mirkio90/spinlite/README.md

# SpinLite

Conta giri da pochi euro per launcher **Beyblade X**: ESP32-C3 SuperMini + sensore ottico QRE1113 + tasto di presenza della trottola + piccola LiPo, agganciato alla porta del Battle Pass del launcher.
I risultati arrivano al telefono via Bluetooth con lo stesso profilo del Bey Battle Pass, quindi funzionano le app esistenti (BeyGear, Spin Meter, Beyblader Helper, 321GoShoot). Display OLED 128x32 opzionale.

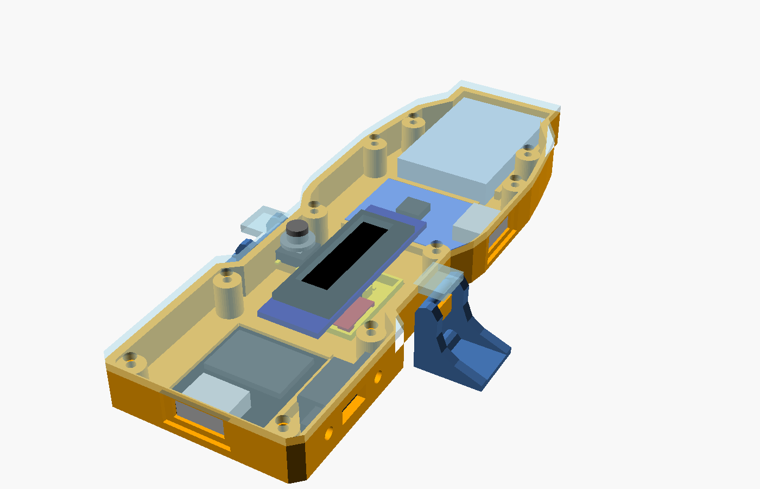
[picture p1: hardware/img/piatta_assieme.png]
Scatola piatta di SpinLite con il coperchio trasparente


Schema di cablaggio

**Costo indicativo: circa 17-21 €** con OLED, 15-19 € senza, prezzi di ottobre 2026: vedi la [distinta base](hardware/BOM.md).

## Link

- [Guida completa](docs/guida.md): distinta base, cablaggio, montaggio, taratura, limiti
- [Dashboard web](https://mirkio90.github.io/spinlite/)
- [Web flasher](https://mirkio90.github.io/spinlite/flasher/)
- [Distinta base (BOM)](hardware/BOM.md)
- [Scatola piatta: stampa e montaggio](docs/scatola-piatta.md)
- [Parti stampate e vecchi montaggi](hardware/README.md)

## Limiti da sapere subito

SpinLite misura l'**albero del launcher**, non la trottola. Con i launcher a corda anche il Battle Pass originale sovrastima gli RPM. Dettagli nella guida.

## Stato

| Parte | Stato |
| --- | --- |
| Rilevatore RPM (`rpm_detector.*`) | fatto: 21 casi simulati, errore tipico sotto lo 0,1% |
| Pacchetti Battle Pass (`bbp_protocol.*`) | fatto, verificato con un parser indipendente |
| Schermate OLED (`oled_ui.*`) | disegno testato; driver I2C da provare |
| Firmware ESP32-C3 (`spinlite.ino`: ADC, BLE, console) | scritto completo, **NON ancora provato su hardware** |
| Guida e BOM | scritte |
| Montaggio | [scatola piatta](docs/scatola-piatta.md) agganciata al launcher, con OLED, tasto di presenza e tasto esterno, verificata solo a CAD e non ancora stampata. Le scatole precedenti restano come archivio |
| Dashboard web e flasher | vedi i link sopra |

Finché non è provato sul campo, aspettati bug e soglie da tarare.

## Sviluppo

```
make -C test                  # test su PC (rilevatore, protocollo, OLED, impostazioni, presenza)
pio run -e spinlite_qre       # compila il firmware (QRE1113)
pio run -e spinlite_qre_oled  # con display OLED
pio run -e spinlite_qre -t upload  # carica sulla scheda
```

Il piano di lavoro e le note tecniche sono in `CLAUDE.md`.

## Licenza

MIT. Progetto non affiliato a Takara Tomy né a Hasbro. Crediti e licenze di terzi (LaunchLab, BRD, MarkChan0225, Migbello) nella guida.
