mirkio90/spinlite/hardware/img/interno_lato.png

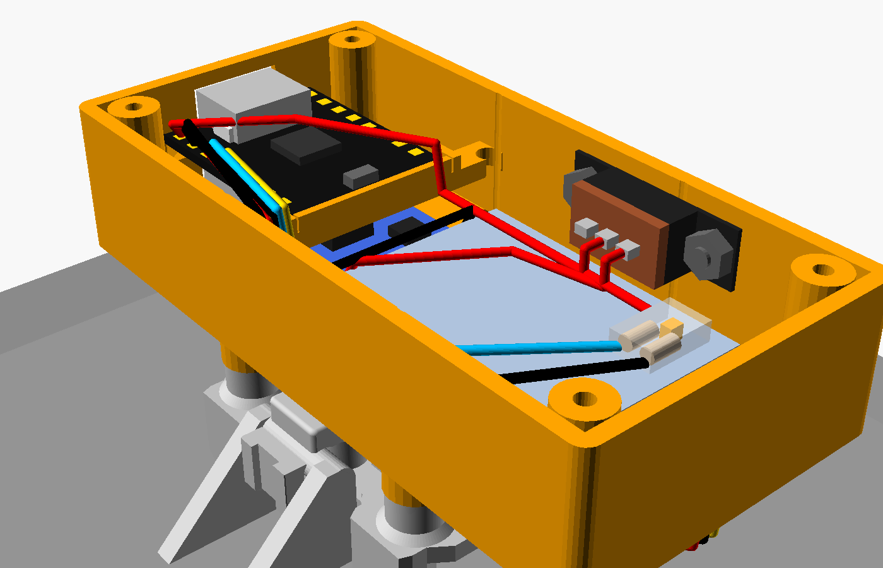
hardware/img/interno_lato.png
