mirkio90/spinlite/hardware/img/interno_oled.png

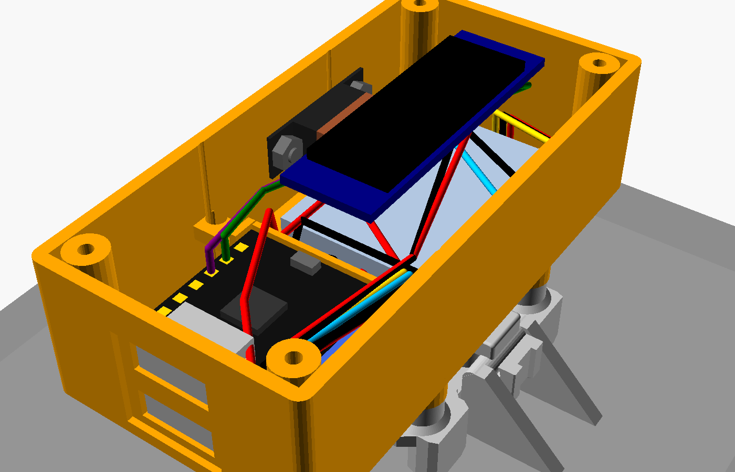
hardware/img/interno_oled.png
