mirkio90/spinlite/hardware/img/render_piatta.png

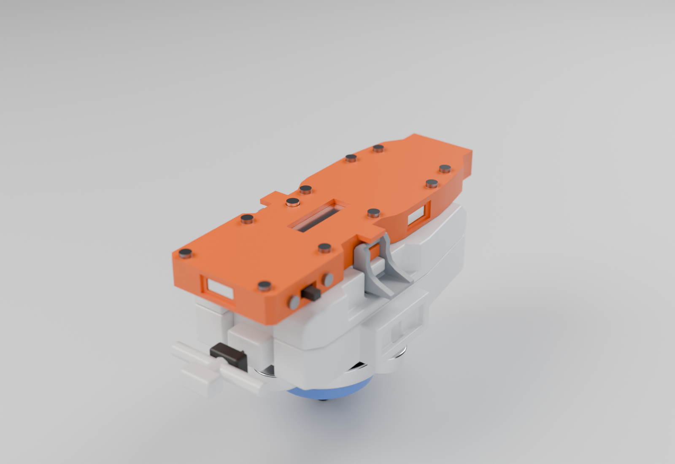
hardware/img/render_piatta.png
