mirkio90/spinlite/hardware/img/render_piatta_clip.png

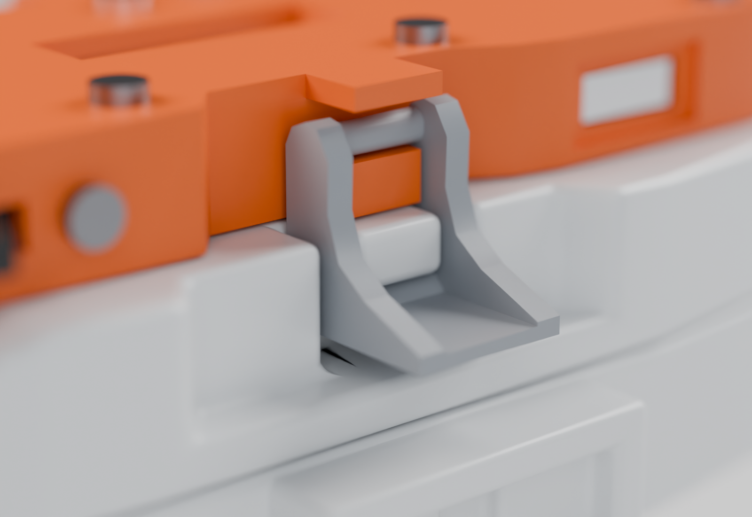
hardware/img/render_piatta_clip.png
