mirkio90/spinlite/hardware/img/render_piatta_fronte.png

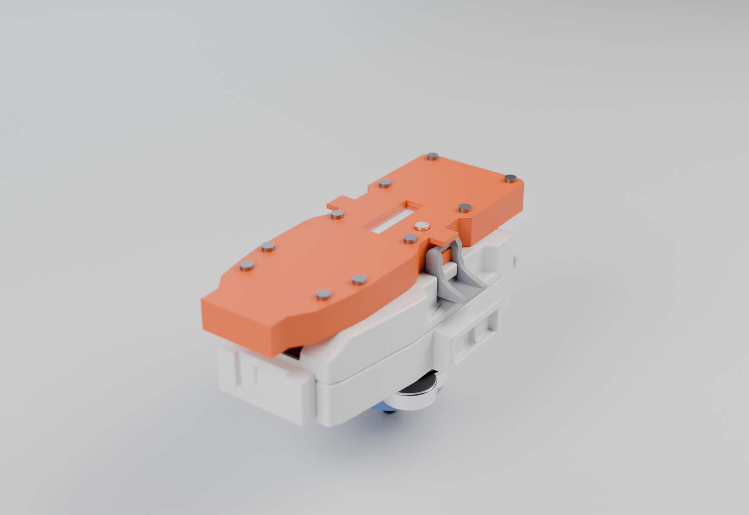
hardware/img/render_piatta_fronte.png
