mirkio90/spinlite/hardware/img/render_piatta_lato.png

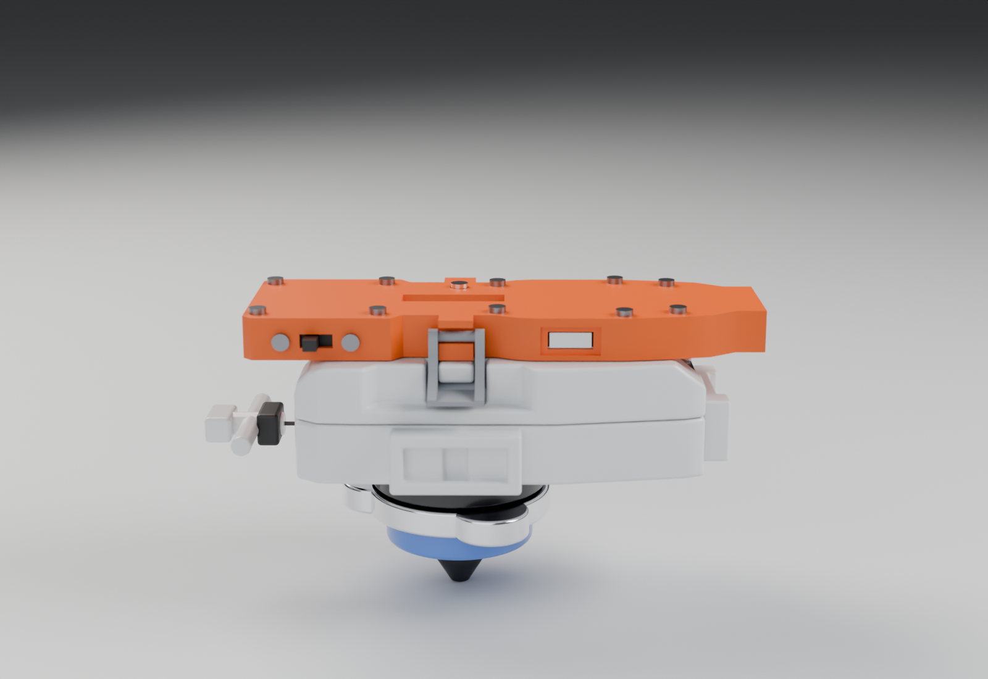
hardware/img/render_piatta_lato.png
