mirkio90/spinlite/hardware/img/render_qre_lato.png

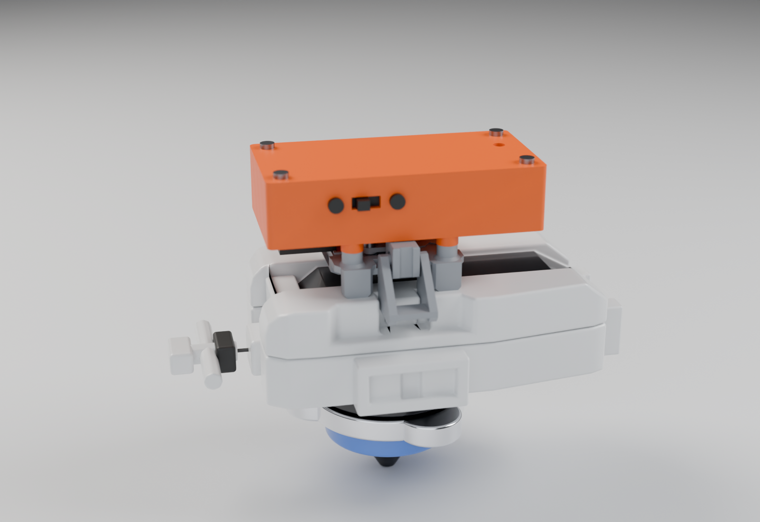
hardware/img/render_qre_lato.png
