mirkio90/spinlite/hardware/img/sezione.png

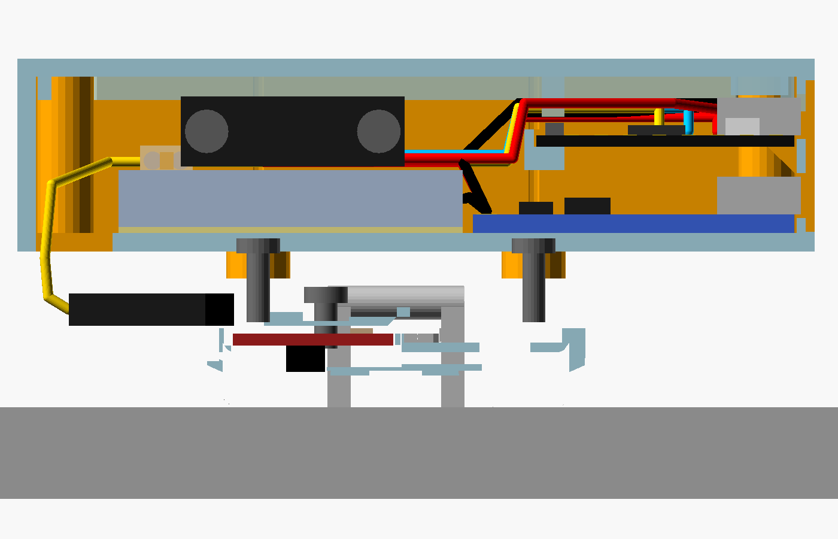
hardware/img/sezione.png
