mirkio90/spinlite/hardware/img/stampa.png

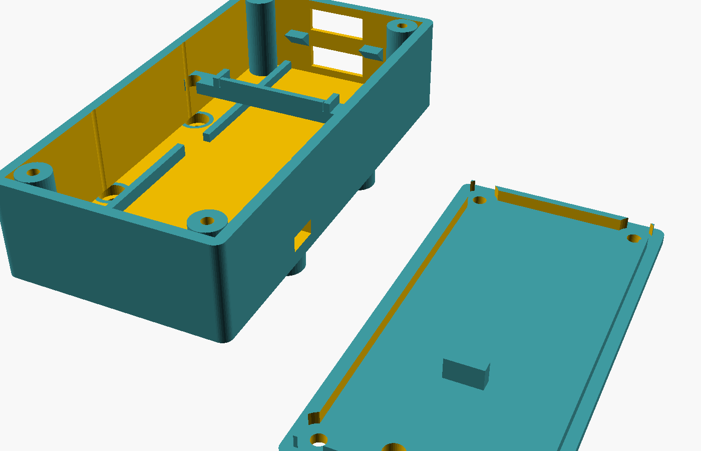
hardware/img/stampa.png
