mirkio90/spinlite/(commit log)

2026-10-20 Avvio progetto: rilevatore RPM e test simulati
    Rilevatore in aritmetica intera per ESP32-C3 (senza FPU), con soglie
    adattive, fronte interpolato a meta' ampiezza, conferma su 3 giri e
    riarmo dopo il riavvolgimento. Simulatore del segnale ottico e test
    su PC. Lavori in corso: alcuni casi (disturbo a meta' giro) da sistemare.
    Claude-Session: https://claude.ai/code/session_01PH6aeQ7hodAxYFRXpk23oL
2026-10-20 Rilevatore: picco solo da giri coerenti, test piu' severi
    Un disturbo che aggiunge un fronte a meta' giro creava due giri falsi
    (es. 0,8 e 1,2 volte il normale) e gonfiava il picco del 17-70%. Ora il
    picco si calcola solo su terne di giri entro il 12% l'una dall'altra.
    Dopo un buco nei dati si passa dal riarmo, cosi' la coda di un lancio
    non diventa un lancio nuovo. Il simulatore misura il riferimento nello
    stesso punto del segno usato dal rilevatore. Aggiunti test con disturbo
    in 12 posizioni e 25 lanci ripetuti.
    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
2026-10-20 Schermate OLED e passaggio di consegne in CLAUDE.md
    Schermate 128x32 (ultimo, massimo, info, messaggio) con font 5x7
    proprio e driver SSD1306 via I2C; disegno testato sul PC in ASCII/PBM.
    CLAUDE.md raccoglie stato, decisioni, progetto del firmware ancora da
    scrivere, trappole dell'ESP32-C3, protocollo e fonti, per continuare
    il lavoro in locale con Claude Code.
    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
2026-10-20 Interfacce dei moduli firmware e platformio.ini
    Header di adc_sampler, ble_bbp, settings e battery: il contratto su cui
    vengono scritte in parallelo le implementazioni. pioarduino 55.03.312-1
    (core 3.3.12) e NimBLE-Arduino 2.5.1, ambienti spinlite e spinlite_oled.
2026-10-20 Dashboard Web Bluetooth e web flasher
    Pagina statica in docs/ per GitHub Pages, scritta da zero: collegamento al
    servizio Battle Pass, stato, storico a barre, curva dell'ultimo lancio,
    checksum e log grezzo. Parser in protocol.js con test Node
    (node docs/protocol.test.mjs); B0 azzera l'assemblatore cosi' un dump
    interrotto non si mescola al successivo. Flasher con esp-web-tools 10.1.1
    per le versioni base e OLED.
2026-10-20 Scatolina parametrica per l'elettronica (OpenSCAD)
    SuperMini, TP4056, LiPo e interruttore; finestrella OLED opzionale,
    coperchio a incastro, stampa senza supporti. Supporti sensore di LaunchLab
    solo linkati (CC BY-SA, Migbello). Non ancora compilata ne' stampata.
    [spinlite_box.scad]
2026-10-20 Firmware completo: acquisizione, BLE, console, impostazioni
    - adc_sampler: ADC1 continuo (DMA) a 50 kHz, pattern S,S,S,S,B, somme da
    4 letture a 10 kHz, calibrazione della frequenza con i tempi dell'ISR,
    overflow -> dataLoss, batteria con calibrazione curve fitting.
    - ble_bbp: servizio Battle Pass con NimBLE 2.5.1, f001 prima di f002,
    comandi in coda, notifiche distanziate, autonotify all'iscrizione.
    - console: aiuto, stato, raw, fronti, storico, cancella, set, salva, default.
    - settings: soglie in blob con versione e CRC, storico in NVS.
    - battery: percentuale LiPo stimata, solo interi.
    - spinlite.ino: LED, pulsante, OLED, salvataggi mai durante la misura.
    - test_settings: codifica so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
2026-10-20 GitHub Actions: test, firmware, release e Pages
    build.yml esegue make -C test e il test del parser web, compila i due
    ambienti e pubblica i .bin (release sui tag v*). pages.yml pubblica docs/
    con le immagini firmware.factory.bin per il web flasher.
2026-10-20 Guida in italiano, schema di cablaggio e nuovo README
    Distinta base con prezzi indicativi, cablaggio, montaggio del sensore con
    i supporti LaunchLab linkati, installazione, taratura con la console,
    limiti della misura sull'albero, crediti e licenze.
2026-10-20 Scatolina: linguetta e bordo del coperchio fusi al corpo
    Verificata in OpenSCAD: la linguetta destra e l'anello del coperchio
    toccavano il corpo solo su una faccia e, per l'arrotondamento di
    outer_x, restavano solidi separati (lo STL aveva 2 pezzi). Ora si
    sovrappongono di eps = 0,05 mm: un pezzo unico, anche con oled = true.
    [spinlite_box.scad]
2026-10-20 Distinta base, montaggio sulla base QRE1113 di LaunchLab
    hardware/BOM.md diventa la distinta ufficiale (QRE1113 analogico con link,
    viteria, filamento, opzionali, totali). hardware/README.md descrive
    l'assemblaggio: base QRE v102 di LaunchLab (linkata a un commit preciso,
    CC BY-SA, non copiata) con la scatola SpinLite avvitata sopra ai 4 fori
    M2 29x24 mm; istruzioni di stampa e adattamenti. Guida corretta: il
    sensore legge l'anello bianco/nero interno del launcher, niente nastro.
    La scatola laterale attuale e' segnata come superata.
2026-10-20 Firmware: profilo per il sensore QRE1113
    Nuovi ambienti spinlite_qre e spinlite_qre_oled (-DSPINLITE_SENSOR_QRE=1).
    Cambia solo minMark: 80 come il profilo QRE di LaunchLab, dove i segni
    veri nella base montata misurano 900-1100 conteggi. Il sensore viene
    indicato all'avvio e in stato. La firma delle soglie salvate in NVS
    dipende dal sensore, cosi' passando da TCRT a QRE non restano le soglie
    dell'altro. Test simulati per il QRE (anello meta' bianco e meta' nero,
    riposo saturo); CI e web flasher con le immagini QRE, ora consigliate.
2026-10-20 Scatola SpinLite da avvitare sopra la base QRE1113 di LaunchLab
    Nuovo hardware/enclosure/spinlite_top.scad: quote d'interfaccia misurate
    sugli STL della base v102 (fori M2 29x24 mm, rilievi a Z 11,2, cerniere
    fino a Z 13,28, spine del sensore), ingombro del dock M5 di LaunchLab con
    4,5 mm in piu' per la curva dei fili. Due piani: LiPo e TP4056 sotto,
    SuperMini sopra su traversa e mensole, USB-C allineate nella stessa parete,
    culla per l'interruttore, coperchio con 4 viti, foro per BOOT, OLED
    opzionale. Verificata a CAD: pezzi unici, nessuna collisione con base,
    clip, spine e componenti (controprova contro il dock M5).
    BOM: SuperMini con link, LiPo 502030, 8 viti M2x6. Guida: versioni del
    fi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
    [spinlite_top.scad]
2026-10-20 Viste di montaggio con tutti i componenti e immagini nel repo
    Nuovo hardware/enclosure/spinlite_views.scad: include la scatola e
    disegna tutti i componenti della BOM (SuperMini, TP4056, LiPo,
    interruttore, partitore sotto guaina, QRE1113 con pettine e spina
    Dupont, viti, OLED opzionale) con i fili indicativi. Viste: montato,
    interno, sezione, esploso. Render in hardware/img/ con didascalie,
    comandi per rigenerarli e attribuzione CC BY-SA per la base LaunchLab
    che compare nelle immagini.
    [spinlite_top.scad, spinlite_views.scad]
2026-10-20 Backlog in CLAUDE.md: IMU per l'inclinazione e altre idee
    Inclinazione con IMU I2C, caratteristica BLE estesa, WiFi/OTA, buzzer,
    spegnimento automatico. Da fare solo dopo la versione base.
2026-10-21 Import locale dei file LaunchLab, fuori da git
    hardware/third_party/fetch_launchlab.py scarica dal commit 87bb60d di
    LaunchLab la base QRE v102 (STL, STEP, 3MF), il dock v098 con l'anteprima
    in coordinate di montaggio, il supporto TCRT v102 e i modelli 3D del sito
    (decompressi con gltf-transform se c'e' Node). La cartella
    hardware/third_party/launchlab/ e' nel .gitignore: i file sono CC BY-SA
    e restano in locale; PROVENIENZA.txt registra commit e hash.
2026-10-21 BOM: link per TP4056, interruttore SS12D00 e condensatori 100 nF
    Note di montaggio: misurare il TP4056 (sembra piu' corto dei 28 mm
    previsti), leva da 4 mm per l'interruttore e piedini accorciati per non
    toccare la LiPo, caricare solo a 5 V.
2026-10-22 BOM: TP4056 di riferimento 28 x 17 mm, il compatto come alternativa
2026-10-22 Autotest: comando 'test' per un lancio finto senza sensore
    Genera su GPIO10 un'onda quadra a velocita' nota (riposo 1,5 s, velocita'
    costante, poi rallenta del 7% ogni 25 ms): con un filo GPIO10 -> GPIO3 il
    rilevatore misura un lancio vero e proprio. Mezzo periodo contato da un
    GPTimer a 1 MHz che inverte il pin nell'interrupt (errore < 0,05%); il
    PWM LEDC accetta solo Hz interi (2% di errore a 1000 RPM).
    Guida passo passo in docs/prova-senza-sensore.md: caricamento, controlli
    all'avvio, lancio finto, verifica handle BLE con nRF Connect, app.
    [autotest.cpp, autotest.h, config.h, console.cpp, console.h]
2026-10-22 Scatola: supporto per l'interruttore SS12F15 con flangia
    Nuovo parametro switch_type (SS12F15 default, SS12D00). L'SS12F15
    si avvita da fuori alla parete +X con 2 viti M2 e dadi, appena sopra la
    LiPo: feritoia per la leva, fori, intaglio nel bordo del coperchio.
    Misure dal disegno del venditore; corsa della leva e passo dei fori
    (15 mm) stimati, da misurare. Verificato a CAD: pezzi unici, nessuna
    collisione con scatola, coperchio, LiPo, SuperMini, TP4056 e base
    LaunchLab. Viste e render aggiornati; BOM con viti e dadi in piu'.
    [spinlite_top.scad, spinlite_views.scad]
2026-11-09 Firmware: presenza della trottola con microswitch opzionale
    Modulo portabile PresenceGate (testato su PC): un lancio vale solo se la
    trottola e' stata inserita prima, il rilascio durante la misura non disarma.
    Il bit 0x04 di A0 segue il contatto. Default spento, comando "presenza".
2026-11-09 Docs: posizione del pistoncino ricavata dai modelli 3D
    Il modello di Dragoon e la tasca sotto la base LaunchLab danno lo stesso
    punto: il pistoncino e' sotto la base, al centro delle cerniere.
2026-11-09 Scatola: sede del tasto di presenza, perni e dima di foratura
    Un tasto SMD 6x6 sotto il fondo, premuto da un perno che sale dal pistoncino
    del launcher attraverso un foro nella base. Cinque altezze di perno, perche'
    la corsa del pistoncino non e' misurata.
    [spinlite_top.scad]
2026-11-09 Docs: montaggio del tasto di presenza, schema in scala
2026-11-09 Docs: pistoncino controllato anche sul launcher a corda
2026-11-09 Scatola piatta: corpo unico che si aggancia al launcher
    Niente base LaunchLab: sensore e tasto di presenza nel fondo, clip stampate
    a parte. Geometria disegnata da zero, dal progetto Dragoon solo idee e quote
    funzionali. Verificata solo a CAD.
    [spinlite_flat.scad]
2026-11-09 Scatola piatta: vassoio del sensore separato dal corpo
    La fascia che sporge sotto il fondo impediva di stampare il corpo senza
    supporti. Ora e' un pezzo a parte, che entra da sotto.
    [spinlite_flat.scad]
2026-11-09 Scatola piatta: sponda del vassoio dentro la sagoma
    Sporgeva di 0,06 mm oltre il vassoio e toccava il fondo del corpo.
    [spinlite_flat.scad]
2026-11-09 Scatola piatta: perno e dente delle clip nella posizione giusta
    Il perno era 1 mm troppo in fuori: la quota veniva dalla clip sinistra del
    modello di riferimento, che e' disallineata. Render con la sede delle clip.
    [spinlite_flat.scad]
2026-11-09 Documentazione: la scatola piatta è la versione attuale
    Verso di montaggio ricavato dalle foto del launcher, cosa cambia in
    distinta base e nota sulla corda sbagliata nei render. La versione con
    schermo resta nel backlog.
2026-11-09 Scatola piatta: OLED, tasto esterno, zone per i LED e spezzone di prova
    L'OLED sta sopra il vassoio senza alzare il corpo. Il tasto esterno va in
    parallelo al BOOT, quindi il firmware non cambia. Piu' gioco tra vassoio
    e apertura per le prime strati in FDM.
    [spinlite_flat.scad]
2026-11-09 Documentazione: hardware/README parte dalla scatola piatta
    OLED, tasto esterno, spezzone di prova e zone per i LED in guida e distinta
    base. Le istruzioni per la base LaunchLab passano sotto Altri montaggi.
    Corretta l'immagine d'assieme, che era vuota.
2026-11-09 Render e documentazione con il launcher nel verso corretto
2026-11-09 Scatola piatta: in plate il cappuccio non si fonde col coperchio
    [spinlite_flat.scad]
2026-11-09 BOM riscritta per la scatola piatta, con consumabili e attrezzi
2026-11-09 Firmware: tasto di presenza obbligatorio, tolto presenza on/off
2026-11-09 Scatola su base LaunchLab: tolti perni, dima di foratura e sede del tasto
    [spinlite_top.scad]
2026-11-09 Documentazione: tasto di presenza obbligatorio, niente foratura
    Riviste guide, distinta, schema di cablaggio e flasher: togli i
    riferimenti al TCRT5000 come sensore principale e alle vecchie scatole
    come alternative.
